TheCacophonyProject/kicad-library/drawings/JNICON_M16_6_pin.step

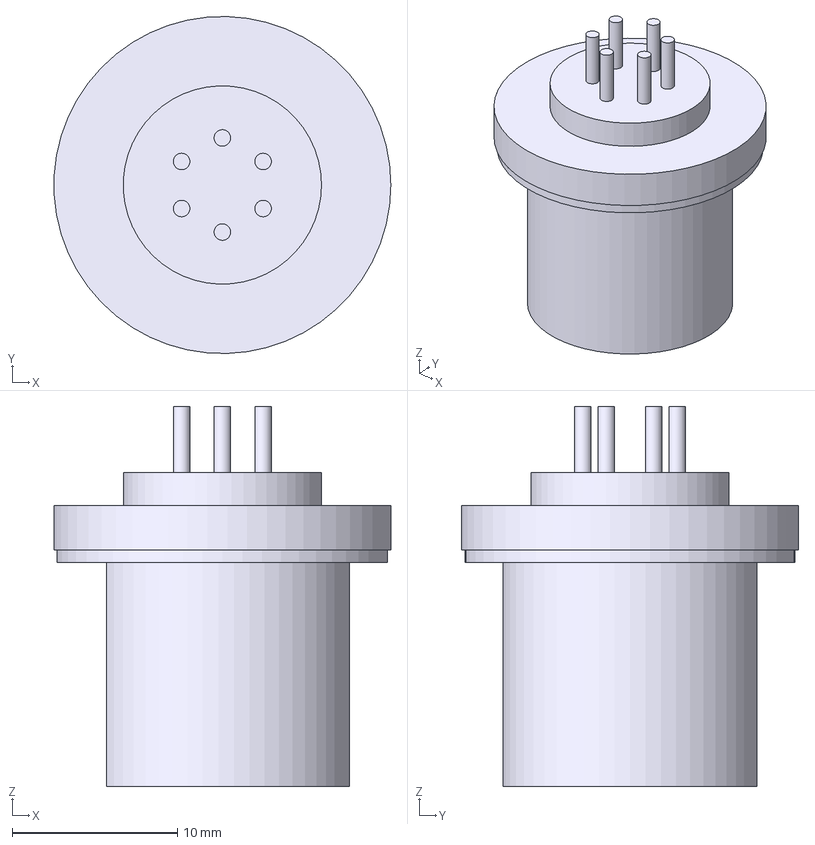
[picture p1: CAD file, 2026-10-15]
drawings/JNICON_M16_6_pin.step
20.4 x 20.4 x 23.0 mm
