TheCacophonyProject/kicad-library/drawings/JNICON_M16_P8-pinout.dxf

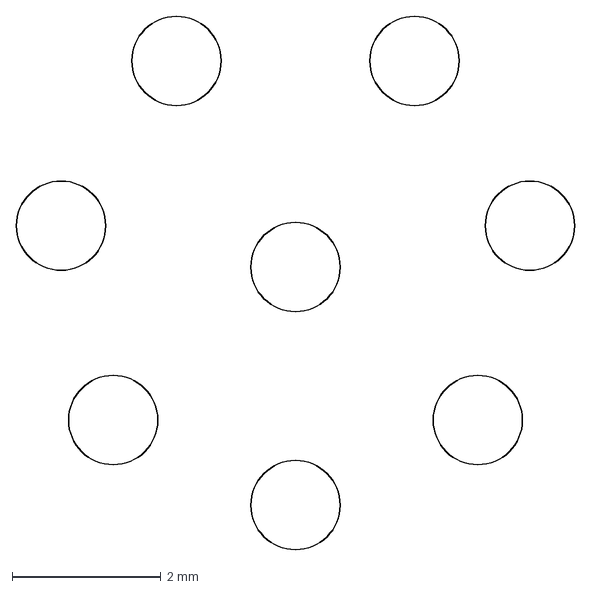
[picture p3: CAD file, 2026-10-15]
drawings/JNICON_M16_P8-pinout.dxf
7.50 x 7.17 mm
