TheCacophonyProject/kicad-library/drawings/RaspberryPi3B-Shape2DView.dxf

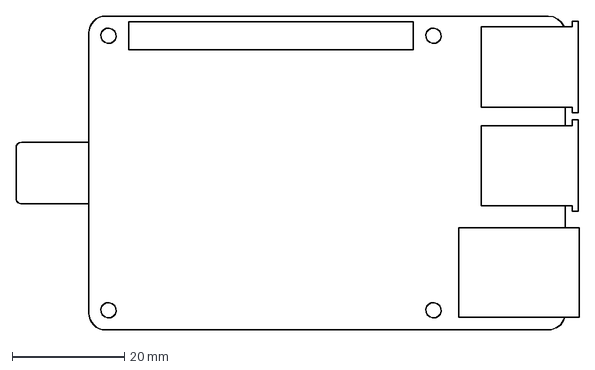
[picture p4: CAD file, 2024-03-23]
drawings/RaspberryPi3B-Shape2DView.dxf
100.5 x 56.0 mm
