TheCacophonyProject/kicad-library/drawings/RaspberryPi3B-Body.step

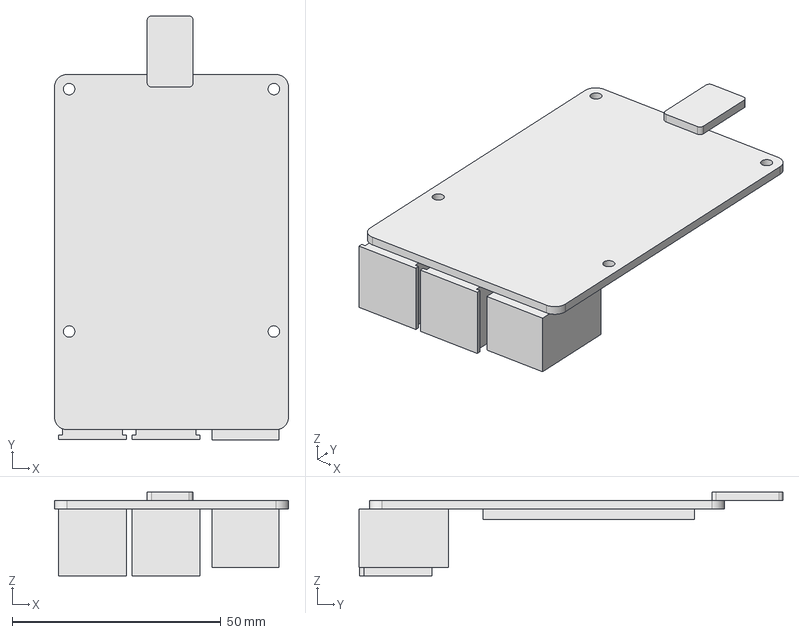
[picture p5: CAD file, 2024-03-23]
drawings/RaspberryPi3B-Body.step
56.0 x 101.5 x 20.0 mm
