TheCacophonyProject/kicad-library/drawings/rpi-zero-2-w.step

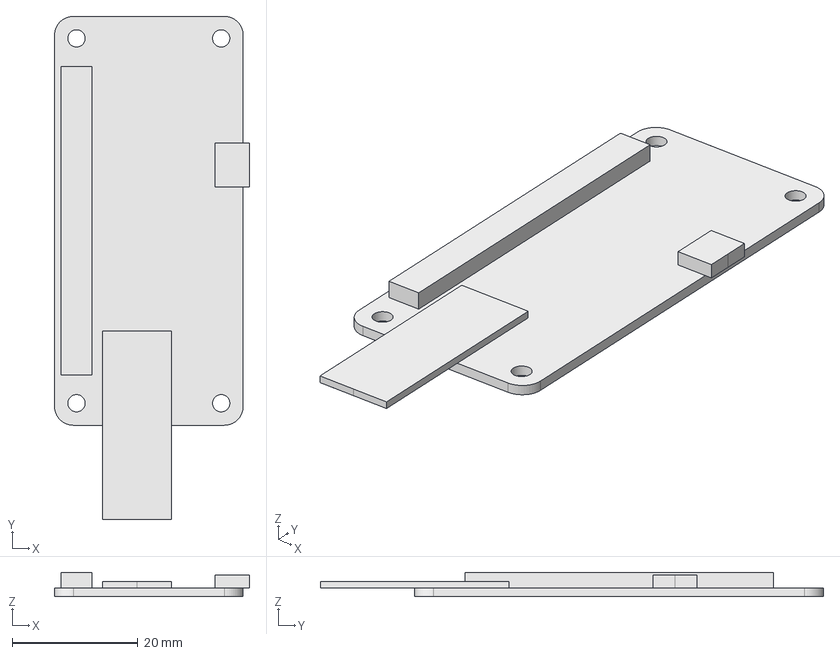
[picture p6: CAD file, 2024-03-23]
drawings/rpi-zero-2-w.step
31.0 x 80.0 x 3.85 mm
