TheCacophonyProject/kicad-library/drawings/18650_case_drawing-Sketch.dxf

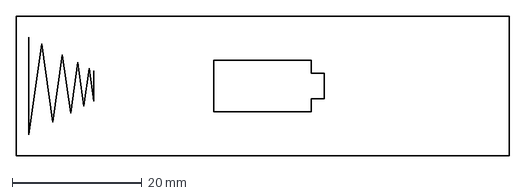
[picture p7: CAD file, 2023-05-10]
drawings/18650_case_drawing-Sketch.dxf
76.0 x 21.5 mm
