TheCacophonyProject/kicad-library/(list of files, cad)

Other CAD files:
drawings/JNICON_M16_4_pin.step
drawings/JNICON_M16.FCStd
drawings/JNICON_M16_P8.FCStd
drawings/rpi-3-hat-features.stl
drawings/rpi-3-hat-boarder.stl
drawings/rpi-3-hat.FCStd
drawings/18650_case_drawing.FCStd
drawings/rpi-3-hat-boarder.dxf
drawings/rpi-3-hat-features.dxf
drawings/rpi-zero-2-w.FCStd
