TheCacophonyProject/kicad-library/SMTWE2070MTJ.pdf

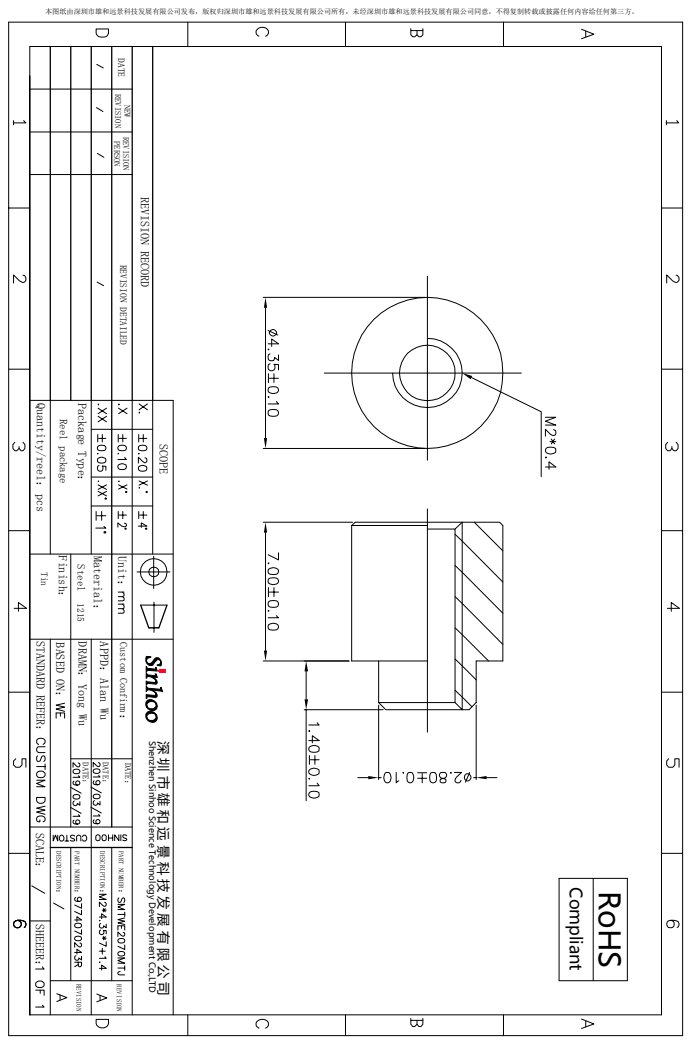
[picture p8: page 1]
Unit：; Material：; Custom Confirm：; REVISION; Finish：; SCALE： SHEEER：; DATE：; Package Type：; DESCRIPTION：; STANDARD REFER：; BASED ON：; SCOPE; Tin; REVISION RECORD; Compliant; RoHS; 本图纸由深圳市雄和远景科技发展有限公司发布，版权归深圳市雄和远景科技发展有限公司所有，未经深圳市雄和远景科技发展有限公司同意，不得复制转载或披露任何内容给任何第三方。 Reel package; Steel 1215 PART NUMBER： DESCRIPTION：

DATE NEW REVISION REVISION PERSON REVISION DETAILED

Quantity/reel：pcs

DRAMN：Yong Wu DATE：

APPD：Alan Wu

Shenzhen Sinhoo Science Technology Development Co.,LTD

REVISION PART NUMBER：
