TheCacophonyProject/kicad-library/cacophony-blocks.kicad_blocks/5V-buck-boost.kicad_block/5V-buck-boost.kicad_pcb

## KiCad design cacophony-blocks.kicad_blocks/5V-buck-boost.kicad_block/5V-buck-boost.kicad_pcb (2026-07-09)

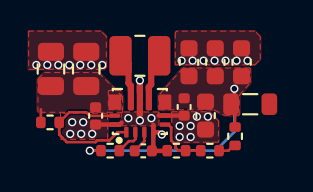
[picture p9: board 5V-buck-boost.kicad_pcb from above]

Board: 4 copper layers, 17 parts (0 on the bottom side), 10 nets.

Parts:
C1, C2: 22uF; C_0805_2012Metric
C3: 2.2uF; C_0402_1005Metric
C4: 100nF; C_0402_1005Metric
C5: 10uF; C_0402_1005Metric
C6, C7, C8, C9: 22uF; C_0603_1608Metric
FB1: FerriteBead; L_0805_2012Metric
L1: 1.5uH; L_1008_2520Metric
R1, R4: 100k; R_0402_1005Metric
R2: 470k; R_0402_1005Metric
R3: 68k; R_0402_1005Metric
R5: 10k; R_0402_1005Metric
U1: TPS63070

Connections:
5V_EN: R5.2, U1.1 (PS/SYNC), U1.14 (EN)
/5V_L1: L1.1, U1.11 (L1)
/5V_L2: L1.2, U1.9 (L2)
/5V_PG: R4.2, U1.2 (PG)
/5V_PHY: C5.1, C6.1, C7.1, C8.1, C9.1, FB1.1, R2.1, R4.1, U1.7,8 (Vout)
GND: C1.2, C2.2, C3.2, C4.2, C5.2, C6.2, C7.2, C8.2, C9.2, R1.2, U1.4 (GND), U1.6 (FB2), U1.10 (PGND), U1.15 (Vsel)
unnamed: R2.2, R3.2
unnamed: R1.1, R3.1, U1.5 (FB)
unnamed: C4.1, U1.3 (Vaux)
VCC: C1.1, C2.1, C3.1, R5.1, U1.12,13 (Vin)
