TheCacophonyProject/kicad-library/cac-design-blocks.kicad_blocks/RTC-PCF8563.kicad_block/RTC-PCF8563.kicad_sch

## KiCad design cac-design-blocks.kicad_blocks/RTC-PCF8563.kicad_block/RTC-PCF8563.kicad_sch (2025-12-02)

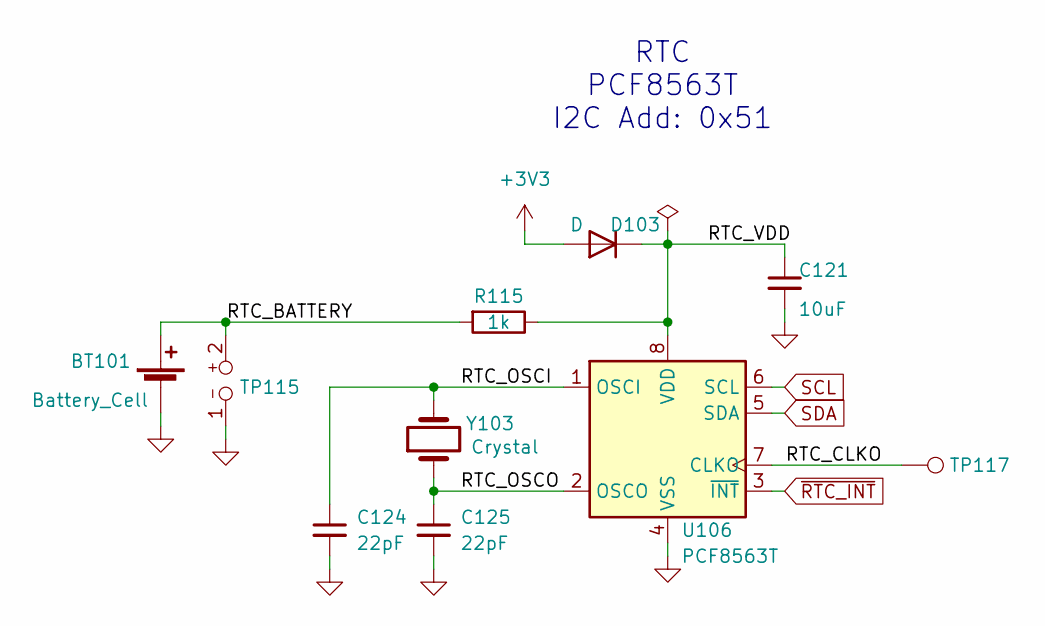
[picture p10: schematic RTC-PCF8563.kicad_sch]

Parts:
BT101: Battery_Cell; CAP-SMD_FL11E; LCSC Part C80909
C121: 10uF; C_0603_1608Metric; LCSC Part C19702
C124, C125: 22pF; C_0402_1005Metric; LCSC Part C1555
D103: D; D_SOD-523; LCSC Part C668989
R115: 1k; R_0402_1005Metric; LCSC Part C11702
TP115: TP_2P; test-point-2p
TP117: TestPoint; TP
U106: PCF8563T; SOIC-8_3.9x4.9mm_P1.27mm; LCSC Part C7440
Y103: Crystal; Crystal_SMD_3215-2Pin_3.2x1.5mm; LCSC Part C32346

Connections:
+3V3: D103.2 (A)
GND: BT101.2 (-), C121.2, C124.2, C125.2, TP115.1, U106.4 (VSS)
RTC_BATTERY: BT101.1 (+), R115.2, TP115.2
RTC_CLKO: TP117.1, U106.7 (CLKO)
RTC_OSCI: C124.1, U106.1 (OSCI), Y103.2
RTC_OSCO: C125.1, U106.2 (OSCO), Y103.1
RTC_VDD: C121.1, D103.1 (K), R115.1, U106.8 (VDD)
SCL: U106.6 (SCL)
SDA: U106.5 (SDA)
~RTC_INT: U106.3 (~INT)

Notes on the sheet:
RTC PCF8563T I2C Add: 0x51
