TheCacophonyProject/kicad-library/cac-design-blocks.kicad_blocks/Temp-Humidity-SHT30.kicad_block/Temp-Humidity-SHT30.kicad_sch

## KiCad design cac-design-blocks.kicad_blocks/Temp-Humidity-SHT30.kicad_block/Temp-Humidity-SHT30.kicad_sch (2026-11-11)

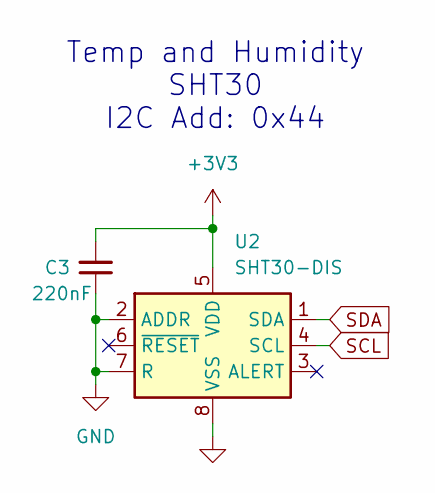
[picture p11: schematic Temp-Humidity-SHT30.kicad_sch]

Parts:
C3: 220nF; C_0402_1005Metric; LCSC Part C16772
U2: SHT30-DIS; Sensirion_DFN-8-1EP_2.5x2.5mm_P0.5mm_EP1.1x1.7mm; LCSC Part C77361

Connections:
+3V3: C3.2, U2.5 (VDD)
GND: C3.1, U2.2 (ADDR), U2.7 (R), U2.8 (VSS), U2.9 (VSS)
SCL: U2.4 (SCL)
SDA: U2.1 (SDA)

Notes on the sheet:
Temp and Humidity SHT30 I2C Add: 0x44
