TheCacophonyProject/kicad-library/(commit log)

2023-05-10 Added more parts
    [18650_case_drawing-Sketch.dxf, 18650_case_drawing.FCStd]
2025-12-02 Add more parts
    [RTC-PCF8563.kicad_sch, Temp-Humidity-SHT30.kicad_sch]
2026-06-26 Update models
    [5V-buck-boost.kicad_pcb, 5V-buck-boost.kicad_sch, rpi-3-hat-boarder.dxf, rpi-3-hat-boarder.stl, rpi-3-hat-features.dxf, rpi-3-hat-features.stl, rpi-3-hat.FCStd]
2026-06-30 update library for battery tester
2026-06-30 Add more components for battery tester
2026-07-03 Added 5V design block
    [5V-buck-boost.kicad_pcb, 5V-buck-boost.kicad_sch]
2026-07-06 Update 5V buck-boost design block
    [5V-buck-boost.kicad_pcb, 5V-buck-boost.kicad_sch]
2026-07-09 Update library for solar-tester
    [5V-buck-boost.kicad_pcb]
2026-08-02 Update footprints for battery
2026-08-18 Update foorptint for thermal camera
2026-09-17 Add new footprints for thermal-camera
2026-11-11 Add new parts for battery tester
2026-11-12 Add new components for battery tester
